go4retro/TurboMaster/pcb/TurboMaster CPU Schematic_(2017-05-09).png

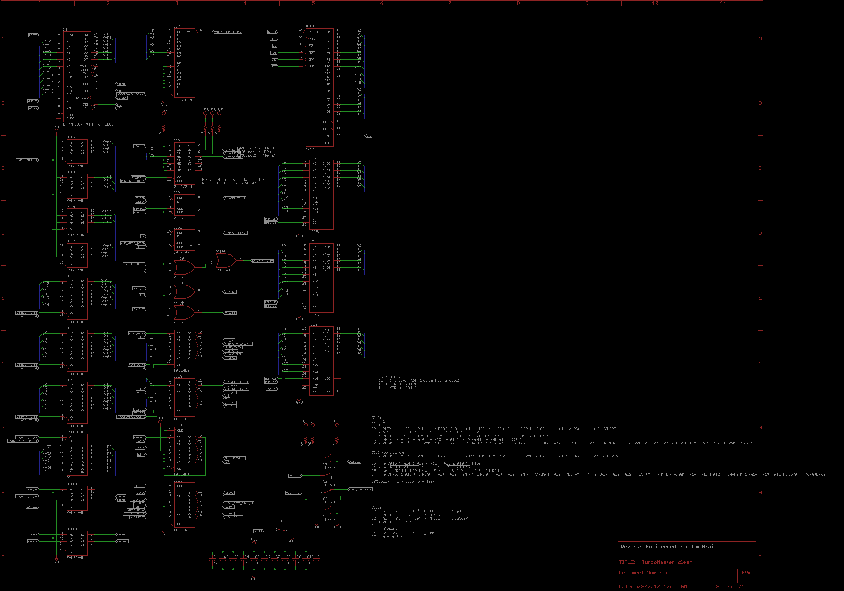
pcb/TurboMaster CPU Schematic_(2017-05-09).png
