go4retro/TurboMaster/pcb/TurboMaster PCB (optimized).png

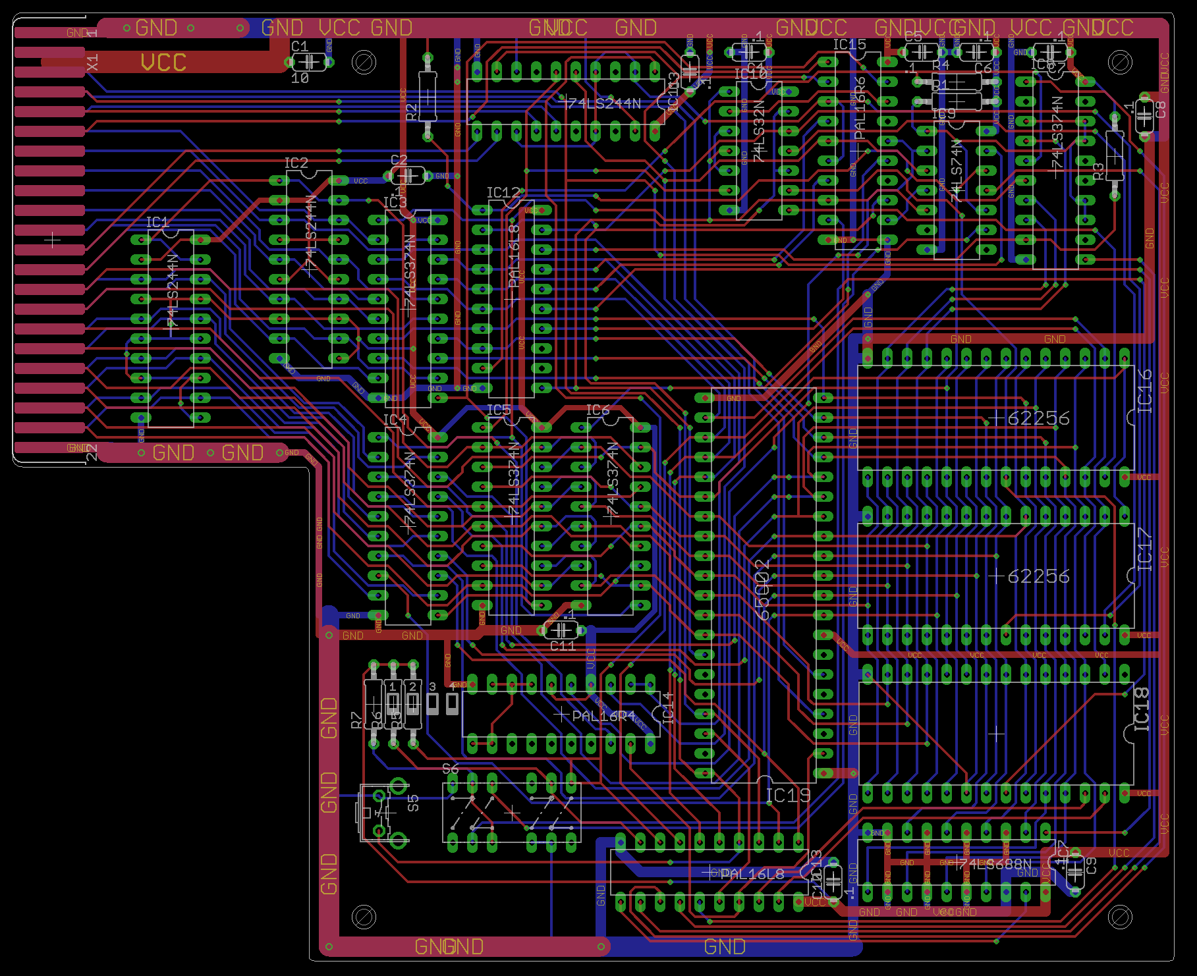
pcb/TurboMaster PCB (optimized).png
