go4retro/TurboMaster/ref/Bottom PCB.png

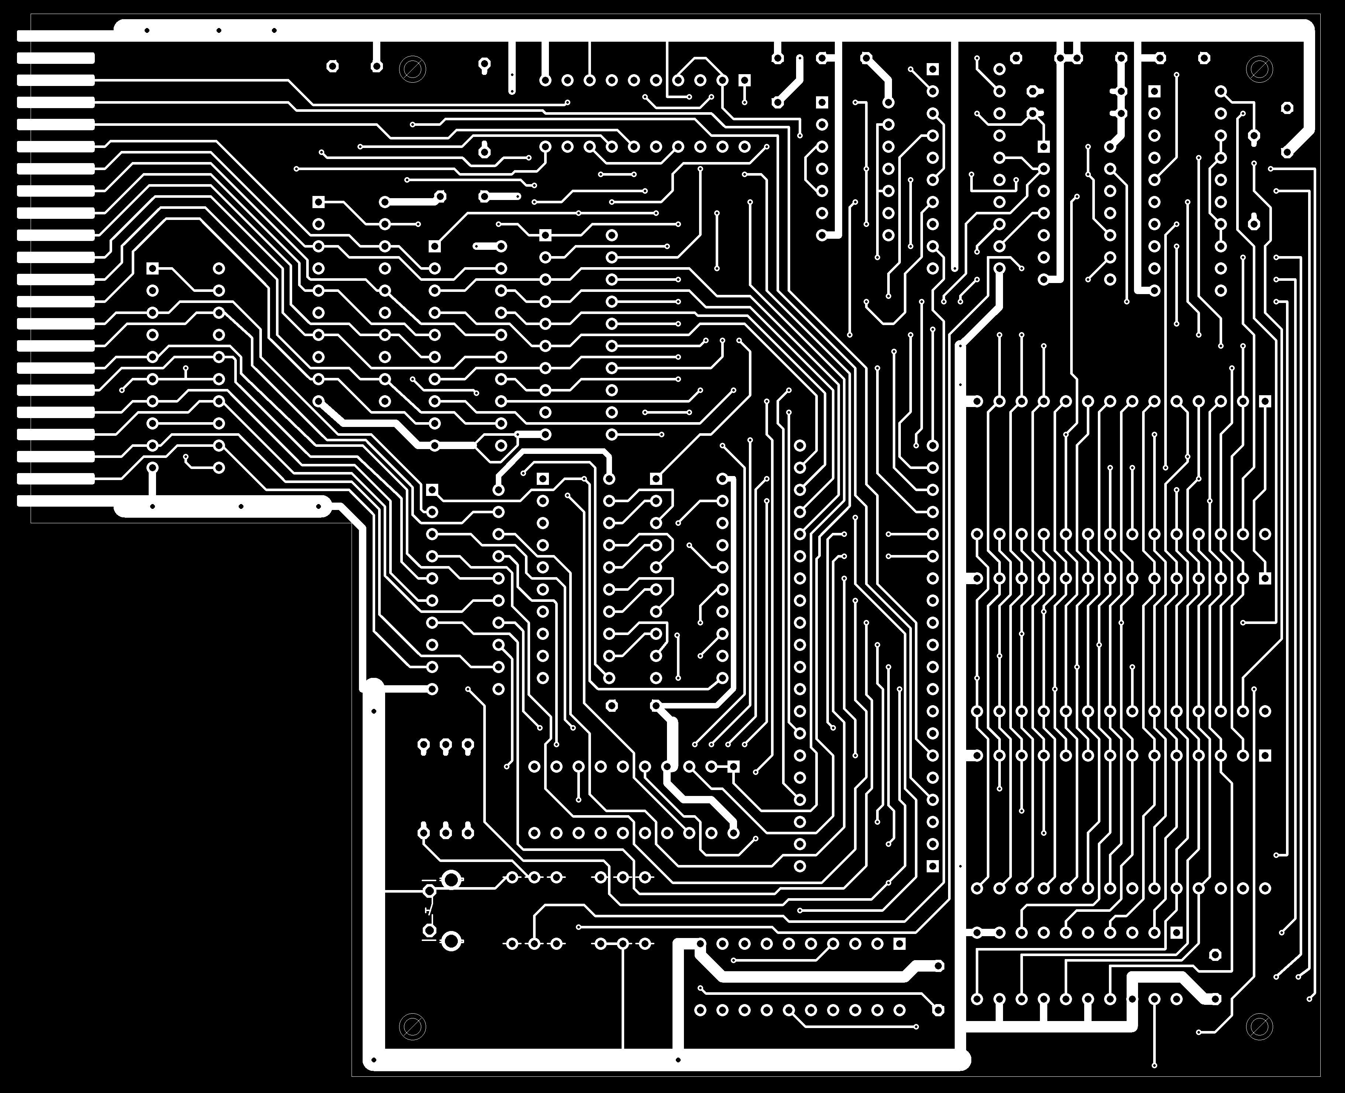
ref/Bottom PCB.png
