go4retro/TurboMaster/ref/Top PCB.png

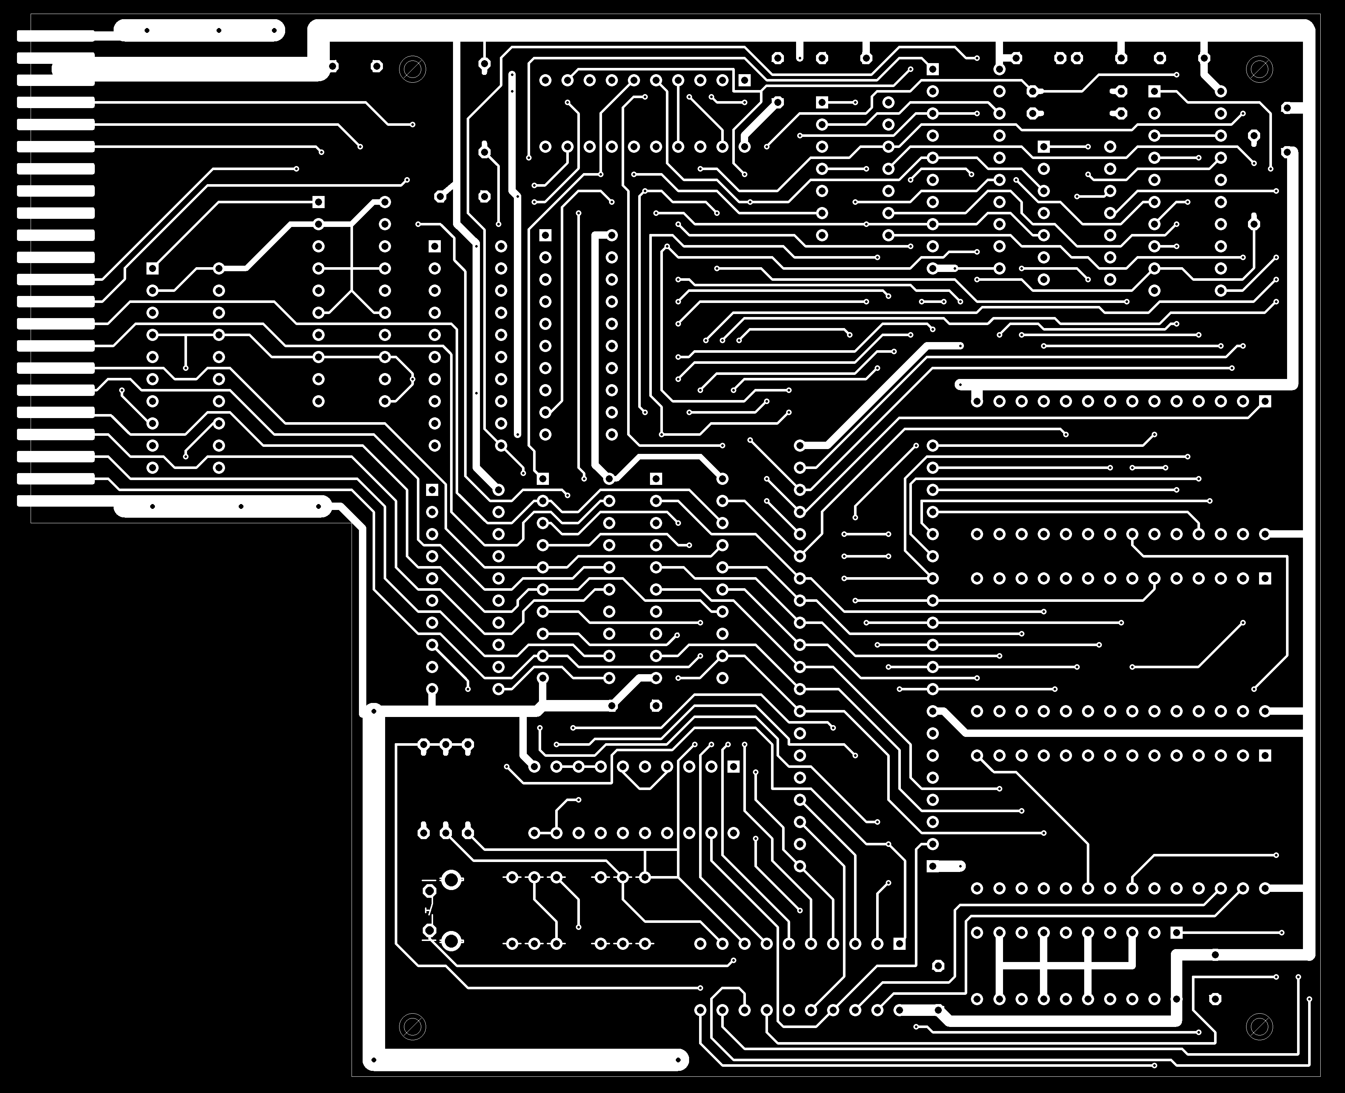
ref/Top PCB.png
