go4retro/TurboMaster/ref/component side bitmap.bmp

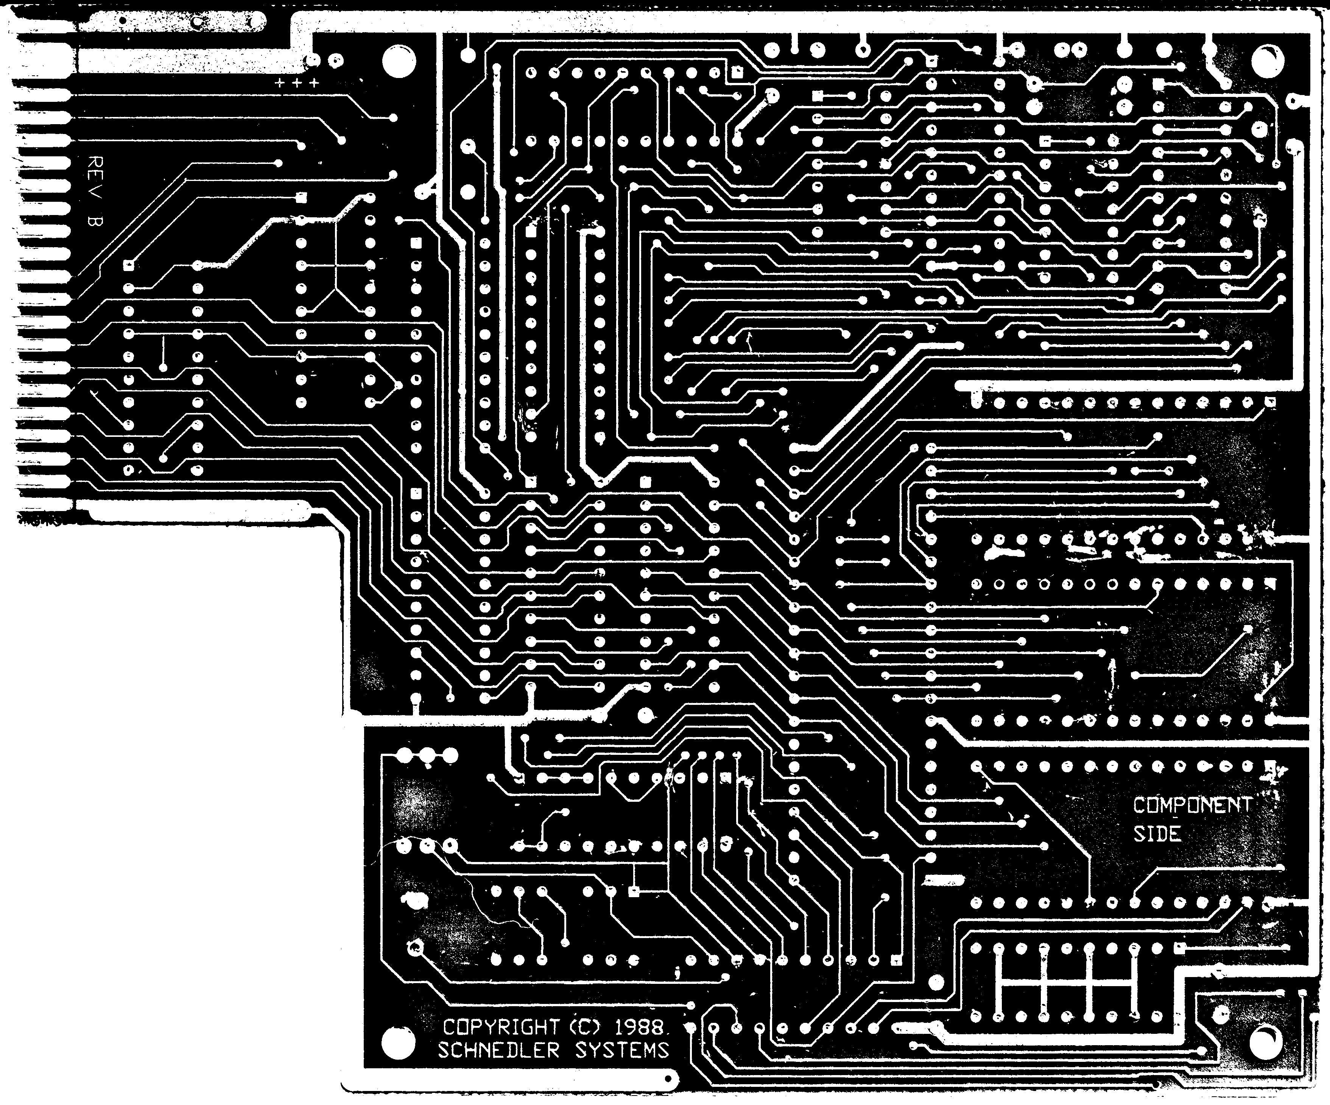
ref/component side bitmap.bmp
