go4retro/TurboMaster/pcb/TurboMaster-clean_noart.brd

## EAGLE design pcb/TurboMaster-clean_noart.brd (2020-07-15)

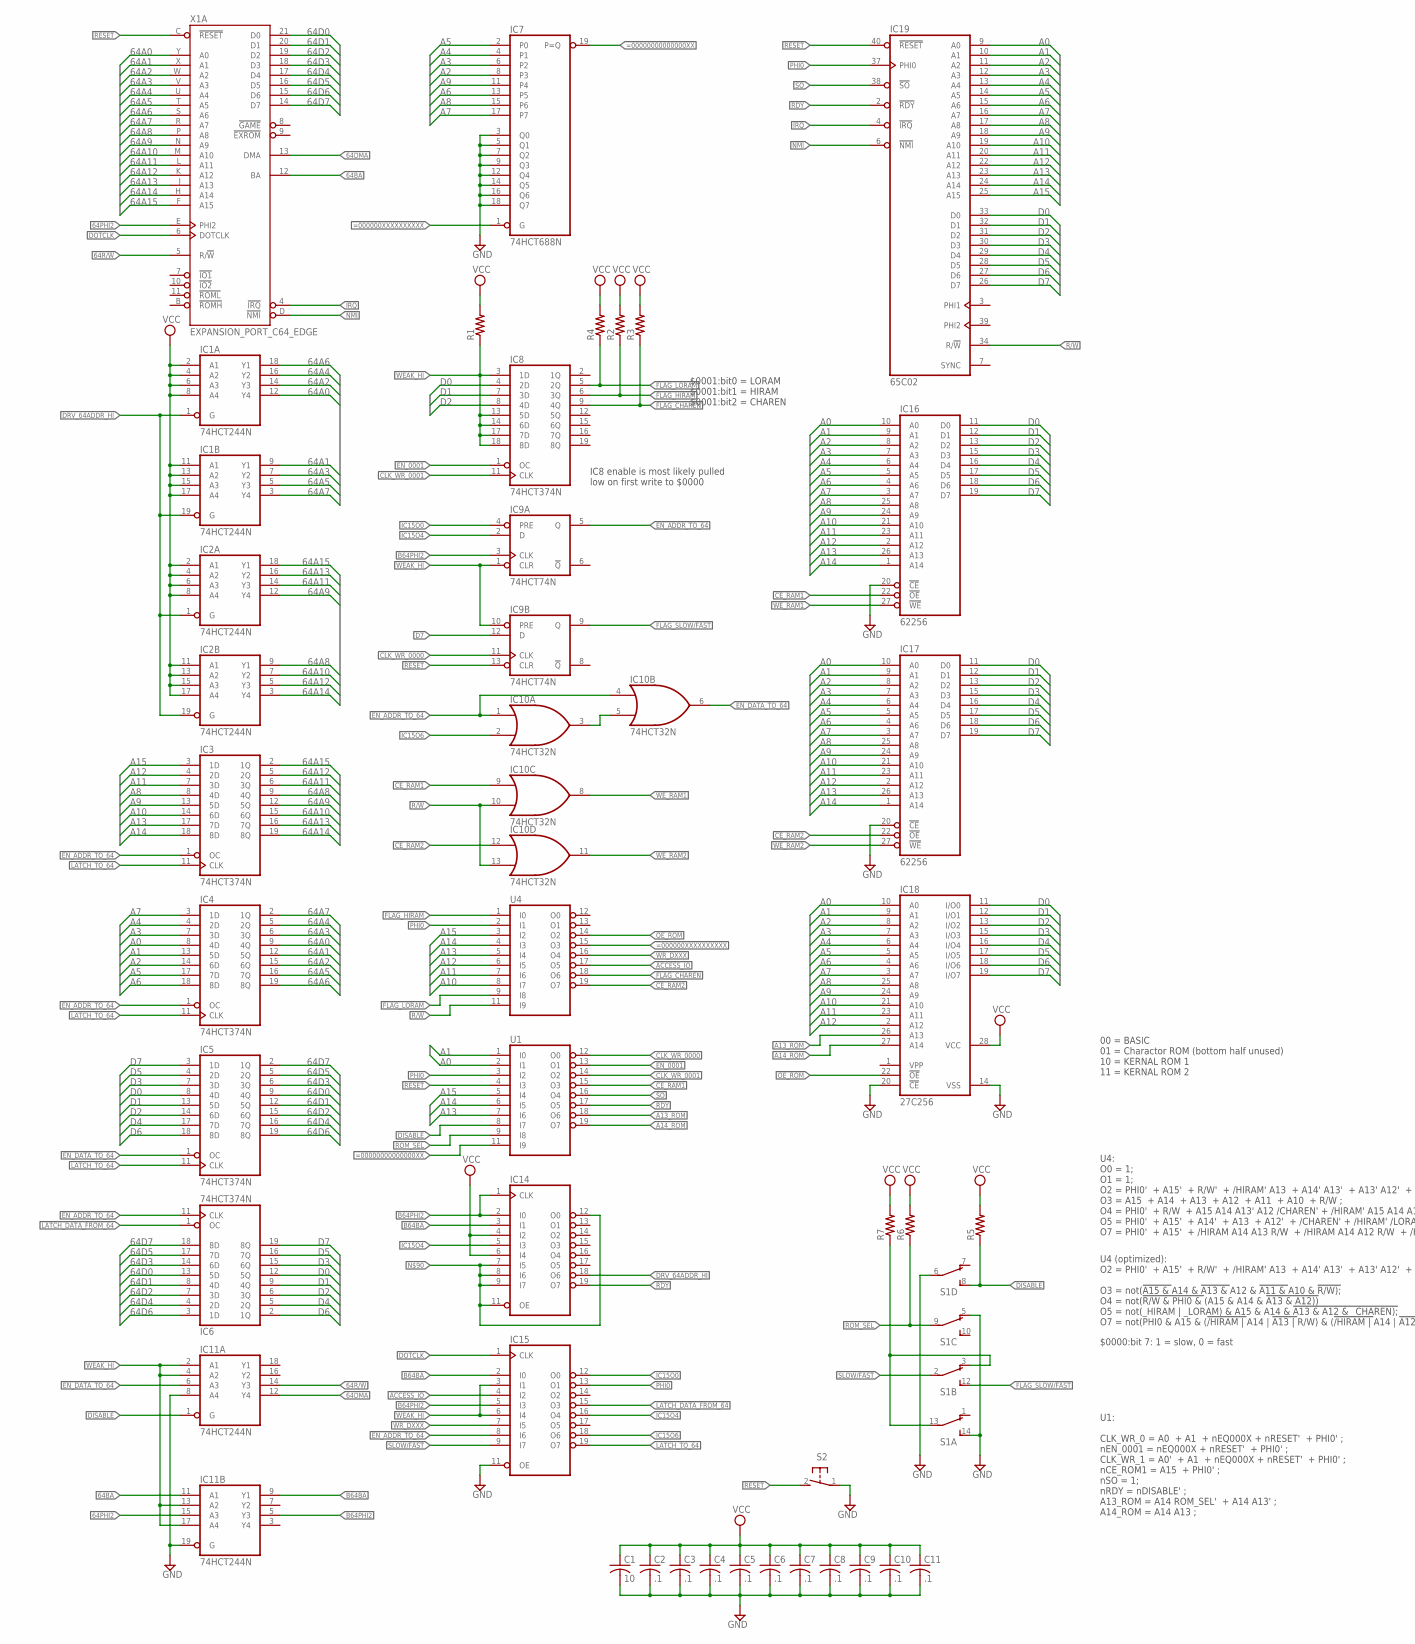
[picture p6: schematic TurboMaster-clean_noart.sch, part in row 1, column 1]

Parts:
C1: 10; C050-024X044
C2, C3, C4, C5, C6, C7, C8, C9, C10, C11: .1; C050-024X044
IC1, IC2, IC11: 74HCT244N; DIL20-RP
IC3, IC4, IC5, IC6, IC8: 74HCT374N; DIL20-RP
IC7: 74HCT688N; DIL20-RP
IC9: 74HCT74N; DIL14-RP
IC10: 74HCT32N; DIL14-RP
IC14: 16R4-RP; DIL20-RP
IC15: 16R6-RP; DIL20-RP
IC16, IC17: 62256; DIL28-6-RP
IC18: 27C256; DIL28-6-RP
IC19: 65C02; DIL40-ROUNDPAD
R1, R2, R3, R4, R5, R6, R7: R-US_0207/10; 0207/10
S1: DIP04DPDTS-RP
S2: 31-XX; B3F-31XX
U1, U4: 16L8-RP; DIL20-RP
X1: EXPANSION_PORT_C64_EDGE; MA100-22-2

Connections:
64A0: IC1.12 (Y4), IC4.9 (4Q), X1.Y (A0)
64A1: IC1.9 (Y1), IC4.12 (5Q), X1.X (A1)
64A2: IC1.14 (Y3), IC4.15 (6Q), X1.W (A2)
64A3: IC1.7 (Y2), IC4.6 (3Q), X1.V (A3)
64A4: IC1.16 (Y2), IC4.5 (2Q), X1.U (A4)
64A5: IC1.5 (Y3), IC4.16 (7Q), X1.T (A5)
64A6: IC1.18 (Y1), IC4.19 (8Q), X1.S (A6)
64A7: IC1.3 (Y4), IC4.2 (1Q), X1.R (A7)
64A8: IC2.9 (Y1), IC3.9 (4Q), X1.P (A8)
64A9: IC2.12 (Y4), IC3.12 (5Q), X1.N (A9)
64A10: IC2.7 (Y2), IC3.15 (6Q), X1.M (A10)
64A11: IC2.14 (Y3), IC3.6 (3Q), X1.L (A11)
64A12: IC2.5 (Y3), IC3.5 (2Q), X1.K (A12)
64A13: IC2.16 (Y2), IC3.16 (7Q), X1.J (A13)
64A14: IC2.3 (Y4), IC3.19 (8Q), X1.H (A14)
64A15: IC2.18 (Y1), IC3.2 (1Q), X1.F (A15)
64BA: IC11.11 (A1), X1.12 (BA)
64D0: IC5.9 (4Q), IC6.13 (5D), X1.21 (D0)
64D1: IC5.12 (5Q), IC6.8 (4D), X1.20 (D1)
64D2: IC5.15 (6Q), IC6.7 (3D), X1.19 (D2)
64D3: IC5.6 (3Q), IC6.14 (6D), X1.18 (D3)
64D4: IC5.16 (7Q), IC6.4 (2D), X1.17 (D4)
64D5: IC5.5 (2Q), IC6.17 (7D), X1.16 (D5)
64D6: IC5.19 (8Q), IC6.3 (1D), X1.15 (D6)
64D7: IC5.2 (1Q), IC6.18 (8D), X1.14 (D7)
64DMA: IC11.12 (Y4), X1.13 (DMA)
64PHI2: IC11.15 (A3), X1.E (PHI2)
64R/!W: IC11.14 (Y3), X1.5 (R/!W)
!=00000000000000XX: IC7.19 (P=Q), U1.11 (I9)
!=000000XXXXXXXXXX: IC7.1 (G), U4.15 (O3)
!ACCESS_IO: IC15.4 (I2), U4.17 (O5)
!CE_RAM1: IC10.9 (I0), IC16.22 (!OE), U1.15 (O3)
!CE_RAM2: IC10.12 (I0), IC17.22 (!OE), U4.19 (O7)
!EN_0001: IC8.1 (OC), U1.13 (O1)
!EN_ADDR_TO_64: IC3.1 (OC), IC4.1 (OC), IC6.11 (CLK), IC9.5 (Q), IC10.1 (I0), IC10.4 (I0), IC15.8 (I6)
!EN_DATA_TO_64: IC5.1 (OC), IC10.6 (O), IC11.6 (A3)
!FLAG_CHAREN: IC8.9 (4Q), R3.1, U4.18 (O6)
!FLAG_HIRAM: IC8.6 (3Q), R2.1, U4.1 (I0)
!FLAG_LORAM: IC8.5 (2Q), R4.1, U4.9 (I8)
!IRQ: IC19.4 (!IRQ), X1.4 (!IRQ)
!LATCH_DATA_FROM_64: IC6.1 (OC), IC15.15 (O3)
!NMI: IC19.6 (!NMI), X1.D (!NMI)
!OE_ROM: IC18.22 (!OE), U4.14 (O2)
!RDY: IC14.19 (O7), IC19.2 (!RDY), U1.17 (O5)
!RESET: IC9.13 (CLR), IC19.40 (!RESET), S2.2 (S), U1.4 (I3), X1.C (!RESET)
!SO: IC19.38 (!SO), U1.16 (O4)
!WE_RAM1: IC10.8 (O), IC16.27 (!WE)
!WE_RAM2: IC10.11 (O), IC17.27 (!WE)
!WR_DXXX: IC15.7 (I5), U4.16 (O4)
A0: IC4.8 (4D), IC16.10 (A0), IC17.10 (A0), IC18.10 (A0), IC19.9 (A0), U1.2 (I1)
A1: IC4.13 (5D), IC16.9 (A1), IC17.9 (A1), IC18.9 (A1), IC19.10 (A1), U1.1 (I0)
A2: IC4.14 (6D), IC7.8 (P3), IC16.8 (A2), IC17.8 (A2), IC18.8 (A2), IC19.11 (A2)
A3: IC4.7 (3D), IC7.6 (P2), IC16.7 (A3), IC17.7 (A3), IC18.7 (A3), IC19.12 (A3)
A4: IC4.4 (2D), IC7.4 (P1), IC16.6 (A4), IC17.6 (A4), IC18.6 (A4), IC19.13 (A4)
A5: IC4.17 (7D), IC7.2 (P0), IC16.5 (A5), IC17.5 (A5), IC18.5 (A5), IC19.14 (A5)
A6: IC4.18 (8D), IC7.13 (P5), IC16.4 (A6), IC17.4 (A6), IC18.4 (A6), IC19.15 (A6)
A7: IC4.3 (1D), IC7.17 (P7), IC16.3 (A7), IC17.3 (A7), IC18.3 (A7), IC19.16 (A7)
A8: IC3.8 (4D), IC7.15 (P6), IC16.25 (A8), IC17.25 (A8), IC18.25 (A8), IC19.17 (A8)
A9: IC3.13 (5D), IC7.11 (P4), IC16.24 (A9), IC17.24 (A9), IC18.24 (A9), IC19.18 (A9)
A10: IC3.14 (6D), IC16.21 (A10), IC17.21 (A10), IC18.21 (A10), IC19.19 (A10), U4.8 (I7)
A11: IC3.7 (3D), IC16.23 (A11), IC17.23 (A11), IC18.23 (A11), IC19.20 (A11), U4.7 (I6)
A12: IC3.4 (2D), IC16.2 (A12), IC17.2 (A12), IC18.2 (A12), IC19.22 (A12), U4.6 (I5)
A13: IC3.17 (7D), IC16.26 (A13), IC17.26 (A13), IC19.23 (A13), U1.7 (I6), U4.5 (I4)
A13_ROM: IC18.26 (A13), U1.18 (O6)
A14: IC3.18 (8D), IC16.1 (A14), IC17.1 (A14), IC19.24 (A14), U1.6 (I5), U4.4 (I3)
A14_ROM: IC18.27 (A14), U1.19 (O7)
A15: IC3.3 (1D), IC19.25 (A15), U1.5 (I4), U4.3 (I2)
B64BA: IC11.9 (Y1), IC14.3 (I1), IC15.2 (I0)
B64PHI2: IC9.3 (CLK), IC11.5 (Y3), IC14.1 (CLK), IC14.2 (I0), IC15.5 (I3)
CLK_WR_0000: IC9.11 (CLK), U1.12 (O0)
CLK_WR_0001: IC8.11 (CLK), U1.14 (O2)
D0: IC5.8 (4D), IC6.12 (5Q), IC8.4 (2D), IC16.11 (D0), IC17.11 (D0), IC18.11 (I/O0), IC19.33 (D0)
D1: IC5.13 (5D), IC6.9 (4Q), IC8.7 (3D), IC16.12 (D1), IC17.12 (D1), IC18.12 (I/O1), IC19.32 (D1)
D2: IC5.14 (6D), IC6.6 (3Q), IC8.8 (4D), IC16.13 (D2), IC17.13 (D2), IC18.13 (I/O2), IC19.31 (D2)
D3: IC5.7 (3D), IC6.15 (6Q), IC16.15 (D3), IC17.15 (D3), IC18.15 (I/O3), IC19.30 (D3)
D4: IC5.17 (7D), IC6.5 (2Q), IC16.16 (D4), IC17.16 (D4), IC18.16 (I/O4), IC19.29 (D4)
D5: IC5.4 (2D), IC6.16 (7Q), IC16.17 (D5), IC17.17 (D5), IC18.17 (I/O5), IC19.28 (D5)
D6: IC5.18 (8D), IC6.2 (1Q), IC16.18 (D6), IC17.18 (D6), IC18.18 (I/O6), IC19.27 (D6)
D7: IC5.3 (1D), IC6.19 (8Q), IC9.12 (D), IC16.19 (D7), IC17.19 (D7), IC18.19 (I/O7), IC19.26 (D7)
DISABLE: IC11.1 (G), R5.1, S1.8 (S), U1.8 (I7)
DOTCLK: IC15.1 (CLK), X1.6 (DOTCLK)
DRV_64ADDR_HI: IC1.1 (G), IC1.19 (G), IC2.1 (G), IC2.19 (G), IC14.18 (O6)
FLAG_SLOW/!FAST: IC9.9 (Q), S1.12 (S)
GND: C1.2, C2.2, C3.2, C4.2, C5.2, C6.2, C7.2, C8.2, C9.2, C10.2, C11.2, IC1.10 (GND), IC2.10 (GND), IC3.10 (GND), IC4.10 (GND), IC5.10 (GND), IC6.10 (GND), IC7.3 (Q0), IC7.5 (Q1), IC7.7 (Q2), IC7.9 (Q3), IC7.10 (GND), IC7.12 (Q4), IC7.14 (Q5), IC7.16 (Q6), IC7.18 (Q7), IC8.10 (GND), IC9.7 (GND), IC10.7 (GND), IC11.8 (A4), IC11.10 (GND), IC11.19 (G), IC14.10 (GND), IC15.10 (GND), IC15.11 (OE), IC16.14 (GND), IC16.20 (!CE), IC17.14 (GND), IC17.20 (!CE), IC18.14 (VSS), IC18.20 (!CE), IC19.1 (GND), IC19.21 (GND), S1.5 (O), S1.6, S1.14 (S), S2.1, U1.10 (GND), U4.10 (GND), X1.1 (GND), X1.22 (GND), X1.A (GND), X1.Z (GND)
IC15O0: IC9.4 (PRE), IC15.12 (O0)
IC15O4: IC9.2 (D), IC14.5 (I3), IC15.16 (O4)
IC15O6: IC10.2 (I1), IC15.18 (O6)
LATCH_TO_64: IC3.11 (CLK), IC4.11 (CLK), IC5.11 (CLK), IC15.19 (O7)
unnamed: R7.1, S1.3 (O), S1.13
unnamed: IC10.3 (O), IC10.5 (I1)
unnamed: IC14.7 (I5), IC14.8 (I6), IC14.9 (I7), IC14.11 (OE), IC14.12 (O0)
PHI0: IC15.13 (O1), IC19.37 (PHI0), U1.3 (I2), U4.2 (I1)
R/!W: IC10.10 (I1), IC10.13 (I1), IC19.34 (R/!W), U4.11 (I9)
ROM_SEL: R6.1, S1.9, U1.9 (I8)
SLOW/!FAST: IC15.9 (I7), S1.2
VCC: C1.1, C2.1, C3.1, C4.1, C5.1, C6.1, C7.1, C8.1, C9.1, C10.1, C11.1, IC1.2 (A1), IC1.4 (A2), IC1.6 (A3), IC1.8 (A4), IC1.11 (A1), IC1.13 (A2), IC1.15 (A3), IC1.17 (A4), IC1.20 (VCC), IC2.2 (A1), IC2.4 (A2), IC2.6 (A3), IC2.8 (A4), IC2.11 (A1), IC2.13 (A2), IC2.15 (A3), IC2.17 (A4), IC2.20 (VCC), IC3.20 (VCC), IC4.20 (VCC), IC5.20 (VCC), IC6.20 (VCC), IC7.20 (VCC), IC8.20 (VCC), IC9.14 (VCC), IC10.14 (VCC), IC11.20 (VCC), IC14.4 (I2), IC14.6 (I4), IC14.20 (VCC), IC15.20 (VCC), IC16.28 (VCC), IC17.28 (VCC), IC18.28 (VCC), IC19.8 (VCC), R1.2, R2.2, R3.2, R4.2, R5.2, R6.2, R7.2, U1.20 (VCC), U4.20 (VCC), X1.2 (VCC), X1.3 (VCC)
WEAK_HI: IC8.3 (1D), IC8.13 (5D), IC8.14 (6D), IC8.17 (7D), IC8.18 (8D), IC9.1 (CLR), IC9.10 (PRE), IC11.2 (A1), IC11.4 (A2), IC11.13 (A2), IC11.17 (A4), IC15.3 (I1), IC15.6 (I4), R1.1

Notes on the sheet:
00 = BASIC 01 = Charactor ROM (bottom half unused) 10 = KERNAL ROM 1 11 = KERNAL ROM 2
$0001:bit0 = LORAM $0001:bit1 = HIRAM $0001:bit2 = CHAREN
IC8 enable is most likely pulled low on first write to $0000
Reverse Engineered by: Jim Brain
$0000:bit 7: 1 = slow, 0 = fast
U4: O0 = 1; O1 = 1; O2 = PHI0' + A15' + R/W' + /HIRAM' A13 + A14' A13' + A13' A12' + /HIRAM' /LORAM' + A14' /LORAM' + A13' /CHAREN; O3 = A15 + A14 + A13 + A12 + A11 + A10 + R/W ; O4 = PHI0' + R/W + A15 A14 A13' A12 /CHAREN' + /HIRAM' A15 A14 A13' A12 /LORAM' ; O5 = PHI0' + A15' + A14' + A13 + A12' 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
U1: CLK_WR_0 = A0 + A1 + nEQ000X + nRESET' + PHI0' ; nEN_0001 = nEQ000X + nRESET' + PHI0' ; CLK_WR_1 = A0' + A1 + nEQ000X + nRESET' + PHI0' ; nCE_ROM1 = A15 + PHI0' ; nSO = 1; nRDY = nDISABLE' ; A13_ROM = A14 ROM_SEL' + A14 A13' ; A14_ROM = A14 A13 ;
U4 (optimized): O2 = PHI0' + A15' + R/W' + /HIRAM' A13 + A14' A13' + A13' A12' + /HIRAM' /LORAM' + A14' /LORAM' + A13' /CHAREN; O3 = not(!A15 & !A14 & !A13 & !A12 & !A11 & !A10 & !R/W); O4 = not(!R/W & PHI0 & !(A15 & A14 & !A13 & A12)) O5 = not(_HIRAM | _LORAM) & A15 & A14 & !A13 & A12 & _CHAREN); 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

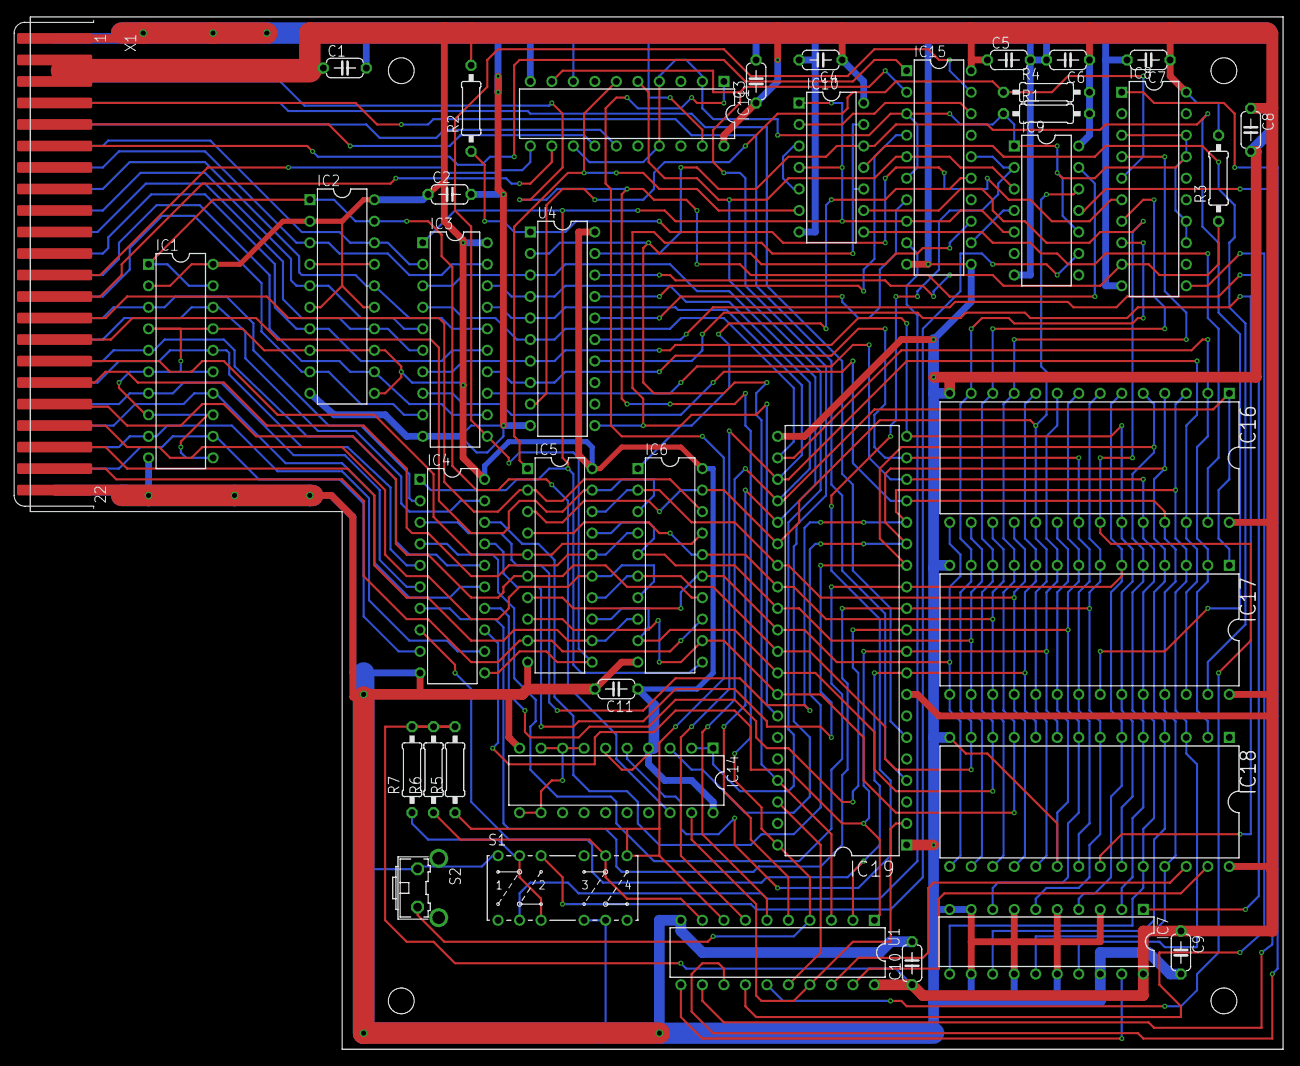
[picture p7: board TurboMaster-clean_noart.brd from above]

Board: 2 copper layers, 148.0 x 121.9 mm, 40 parts (0 on the bottom side), 97 nets.
