go4retro/TurboMaster/ref/solder side bitmap.bmp

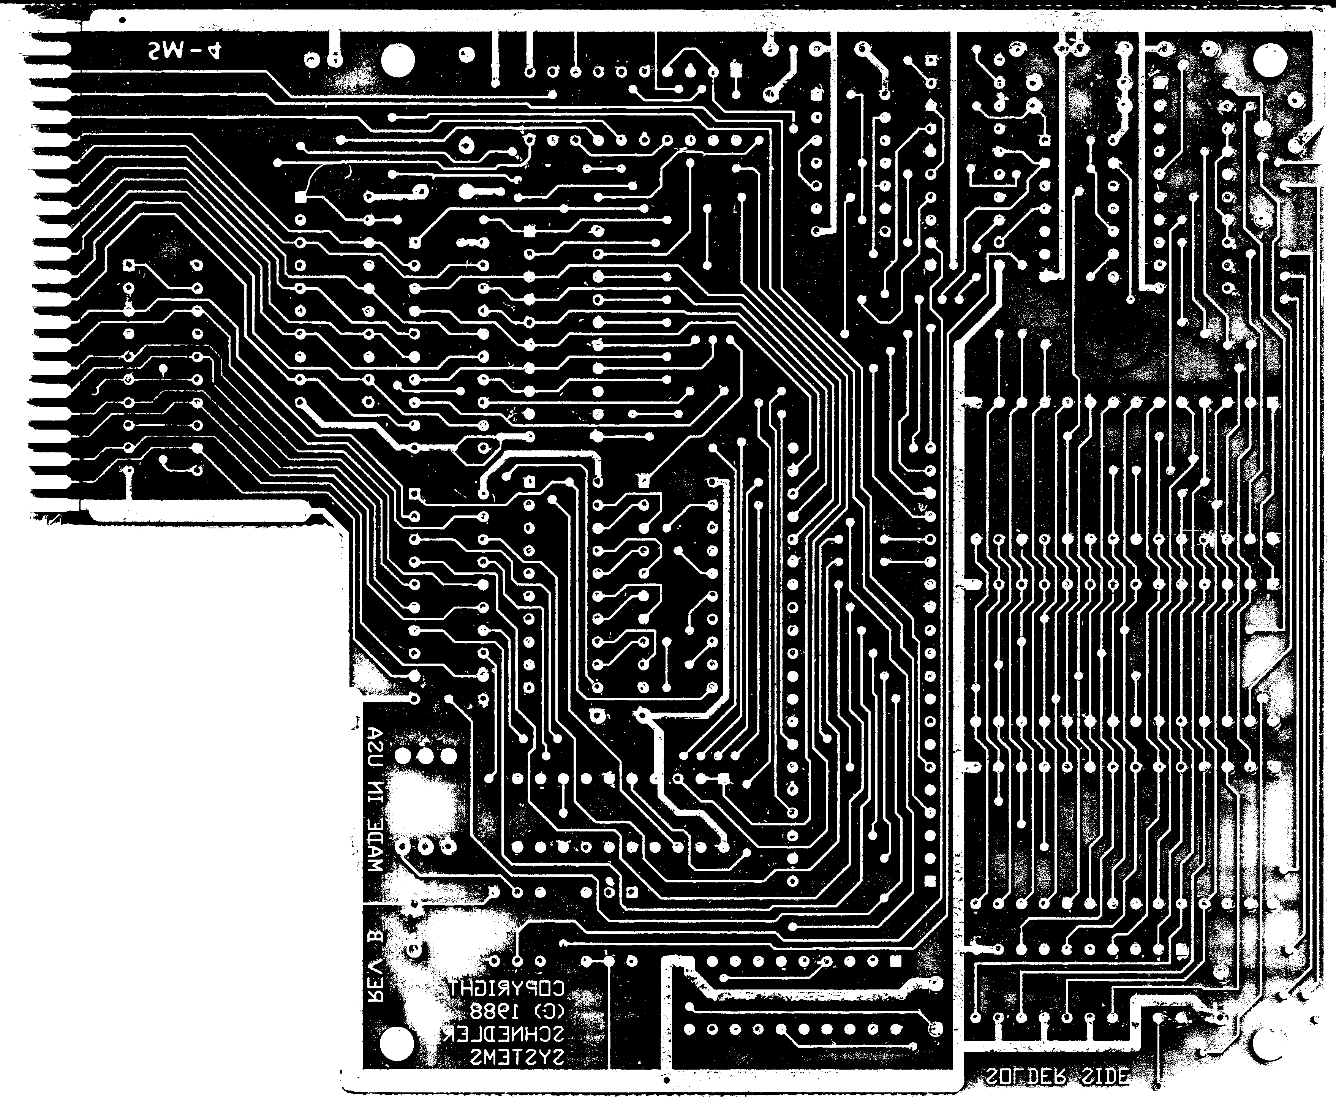
ref/solder side bitmap.bmp
