go4retro/TurboMaster/(commit log)

2020-07-08 Added Debugging.pdn to verify correct PCB design
2020-07-09 Added higher resolution PCB images for comparison
2020-07-11 Schematic signal naming updates
    [TurboMaster-clean.sch, TurboMaster-clean_noart.brd, TurboMaster-clean_noart.sch, TurboMaster-optimized.sch]
2020-07-11 Confirmed working U1 equations and PLD files.
    [u1_1kB.csv]
2020-07-15 Working U1 and U4 JED files
    [TurboMaster-clean_noart.brd, TurboMaster-clean_noart.sch, u1_1kB.csv, u4_2kB.csv]
